fhennecker/semiteleporter/report/final/tasse-defaults-bpa.png

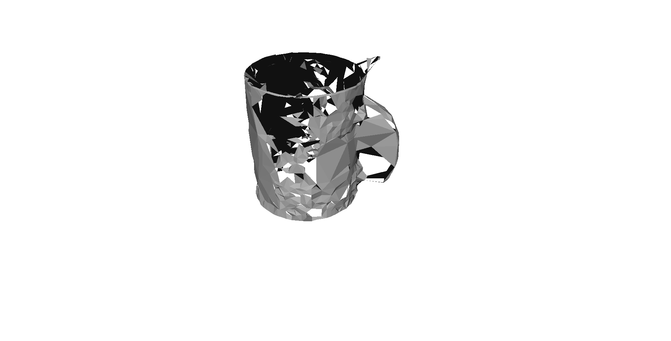
report/final/tasse-defaults-bpa.png
