fhennecker/semiteleporter/research/demo/vase.jpg

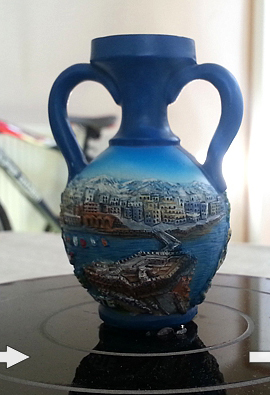
research/demo/vase.jpg
