fhennecker/semiteleporter/research/triangulation_1/11-5+red.bmp

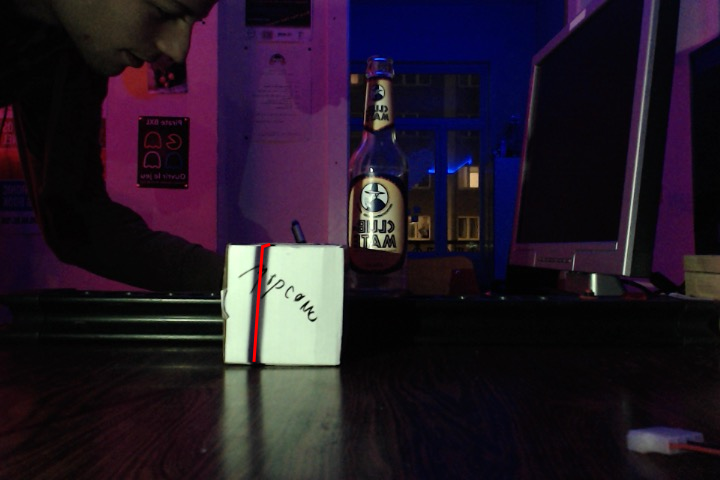
research/triangulation_1/11-5+red.bmp
