fhennecker/semiteleporter/research/triangulation_1/21+red.bmp

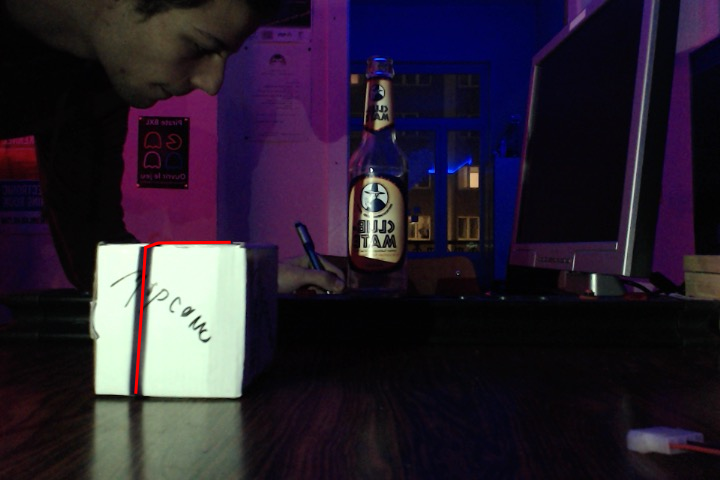
research/triangulation_1/21+red.bmp
