fhennecker/semiteleporter/research/triangulation_1/25+red+cm.bmp

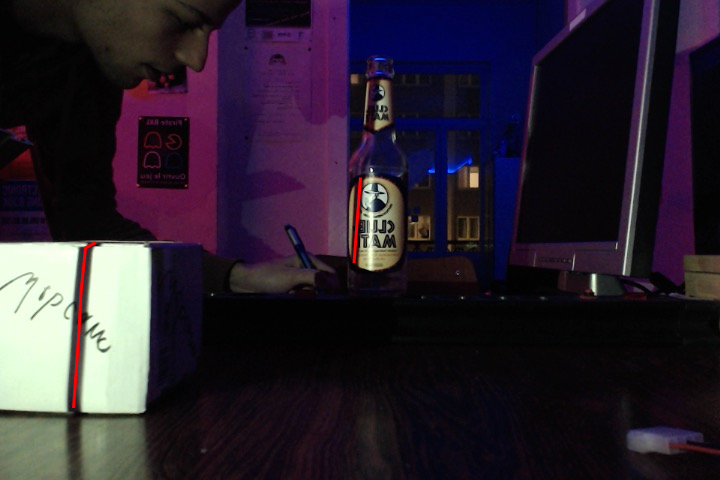
research/triangulation_1/25+red+cm.bmp
