fhennecker/semiteleporter/research/triangulation_1/Photo on 20-11-14 at 20.04 #2.jpg

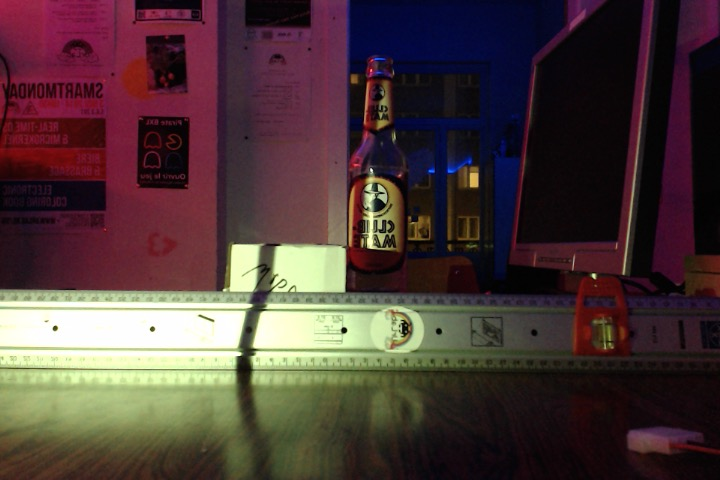
research/triangulation_1/Photo on 20-11-14 at 20.04 #2.jpg
