fhennecker/semiteleporter/research/triangulation_2/repere.png

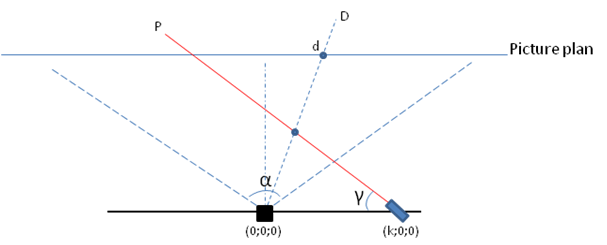
research/triangulation_2/repere.png
