fhennecker/semiteleporter/research/triangulation_3/imgs/04.png

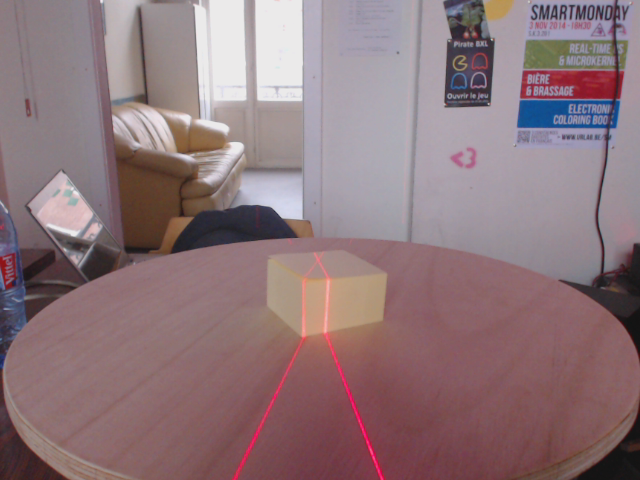
research/triangulation_3/imgs/04.png
