fhennecker/semiteleporter/research/triangulation_3/imgs/14.png

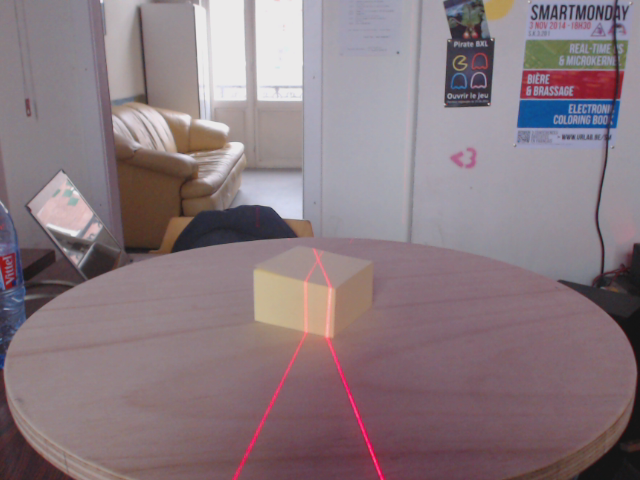
research/triangulation_3/imgs/14.png
