fhennecker/semiteleporter/research/triangulation_3/imgs/32.png

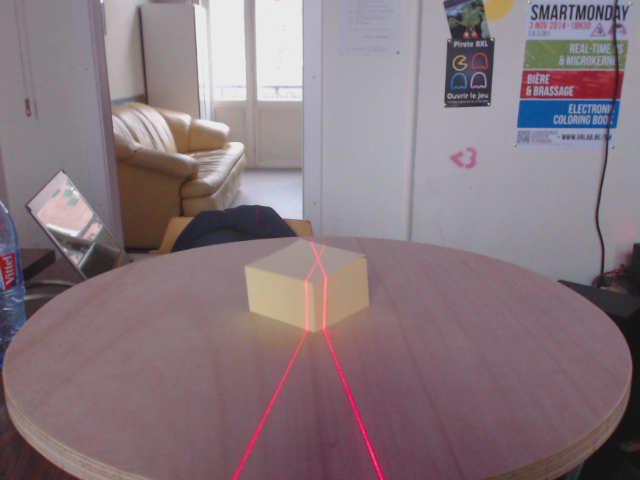
research/triangulation_3/imgs/32.png
