fhennecker/semiteleporter/research/triangulation_3/imgs/45.png

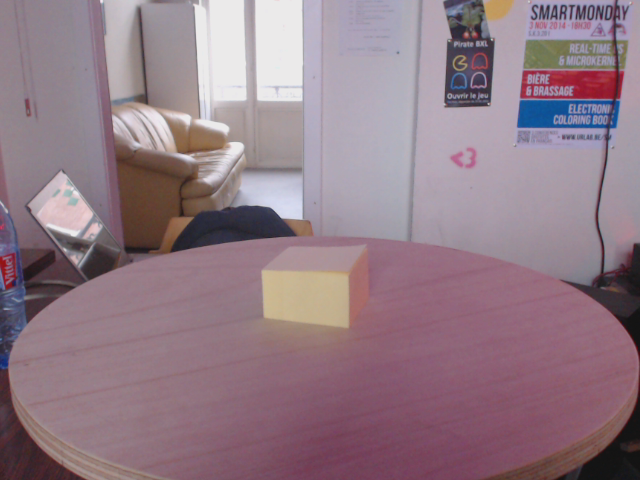
research/triangulation_3/imgs/45.png
