fhennecker/semiteleporter/research/triangulation_3/imgs/50.png

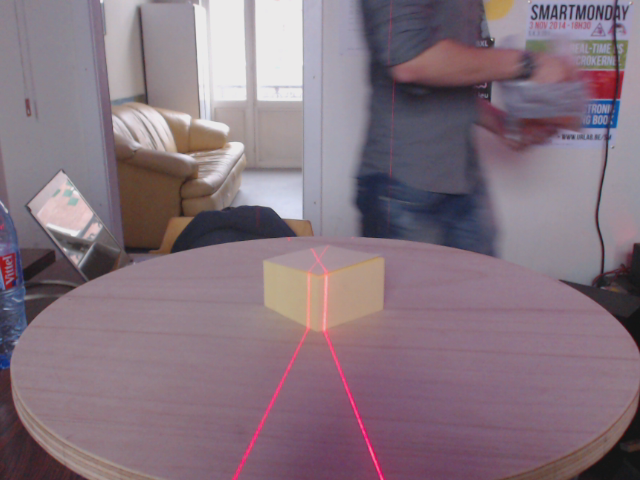
research/triangulation_3/imgs/50.png
