fhennecker/semiteleporter/research/triangulation_3/imgs/51.png

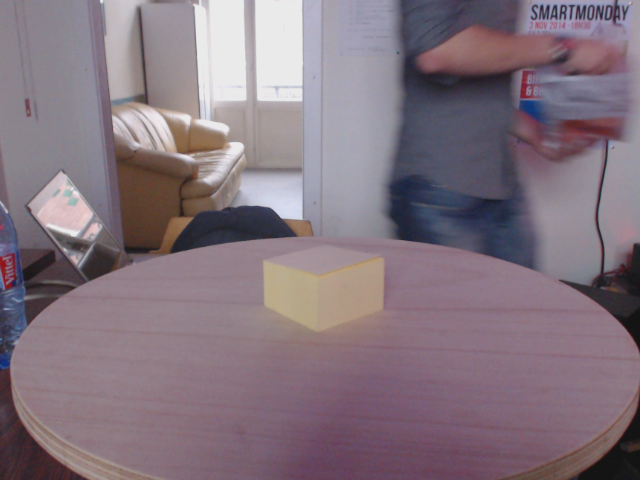
research/triangulation_3/imgs/51.png
