fhennecker/semiteleporter/research/triangulation_4/imgs/00-left.png

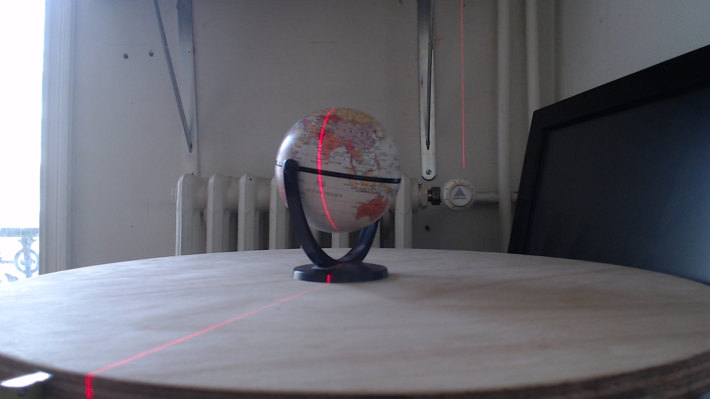
research/triangulation_4/imgs/00-left.png
