fhennecker/semiteleporter/research/triangulation_4/imgs/01-left.png

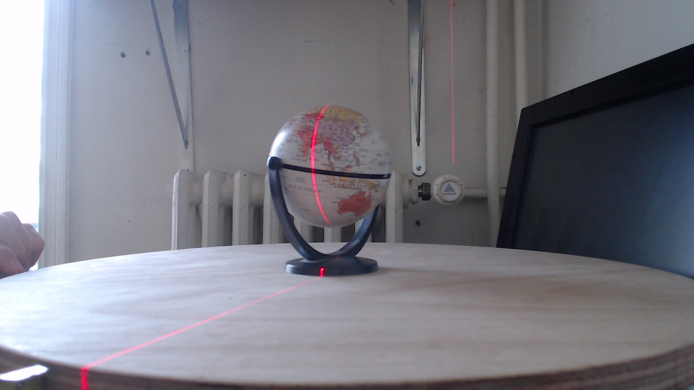
research/triangulation_4/imgs/01-left.png
