fhennecker/semiteleporter/research/triangulation_4/imgs/30-right.png

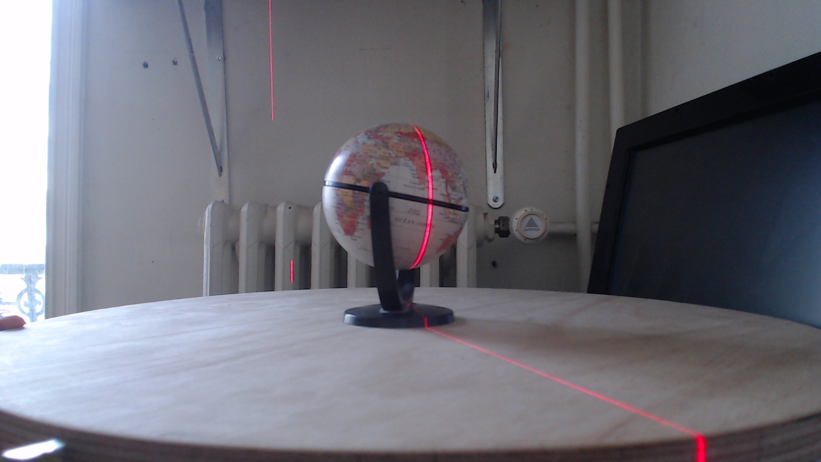
research/triangulation_4/imgs/30-right.png
