fhennecker/semiteleporter/src/points/teapot_up.obj

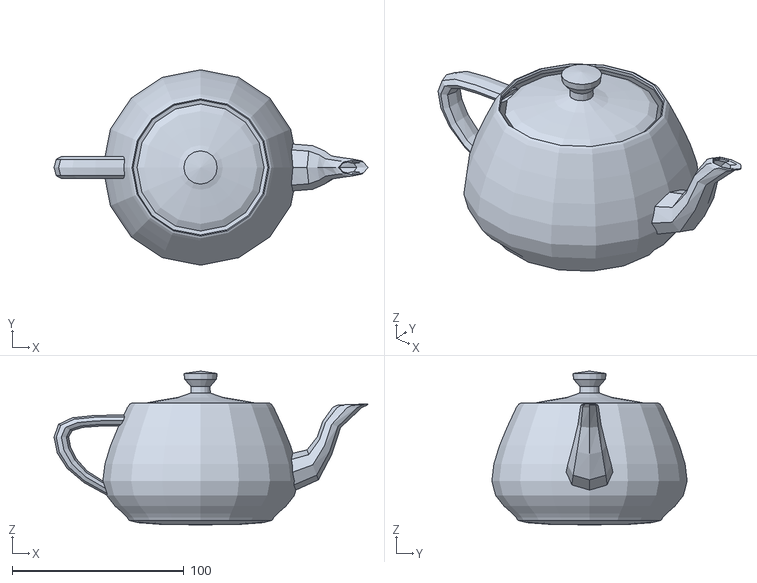
[picture p61: CAD file, 2015-02-26]
src/points/teapot_up.obj
182.7 x 113.7 x 89.5
