fhennecker/semiteleporter/src/points/icoSphere.obj

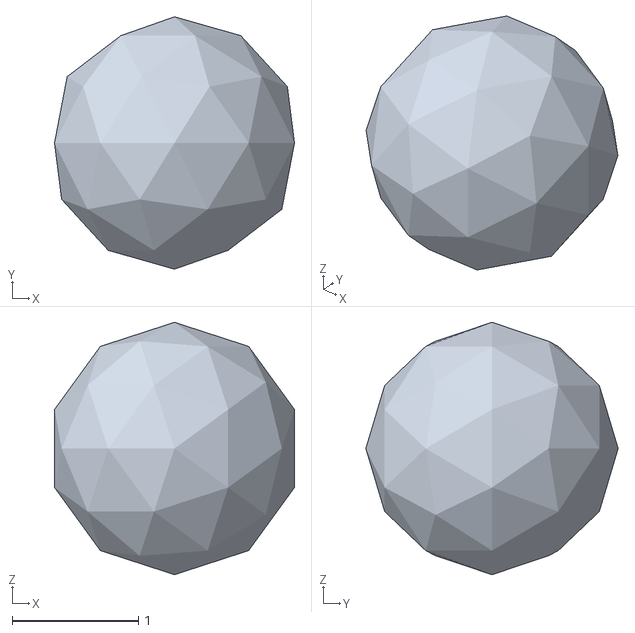
[picture p62: CAD file, 2015-02-26]
src/points/icoSphere.obj
1.90 x 2.00 x 2.00
