fhennecker/semiteleporter/report/final/resultatFinal_jpg.jpg

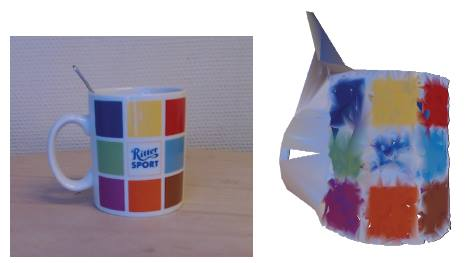
report/final/resultatFinal_jpg.jpg
