fhennecker/semiteleporter/src/default.cfg

[File]
extension = .png
save = ./pictures

[Arduino]
port = /dev/ttyACM0

[LaserRight]
pin = R

[LaserLeft]
pin = L

[Camera]
port = /dev/video1
position = 0.0, 292.0, 0.0
width = 1920.0
height = 1080.0
viewangle = 120.0

[TurnTable]
position = 0.0, 178.0, 350.0
diameter = 500.0
steps = 80.0
