fhennecker/semiteleporter/src/demo/default.cfg

[File]
extension = .png
save = ./pictures

[Arduino]
port = /dev/ttyACM0

[LaserRight]
position = 150.0, 295.0, 0.0
pin = R

[LaserLeft]
position = -150.0, 295.0, 0.0
pin = L

[Camera]
port = /dev/video1
position = 0.0, 295.0, 0.0
rotation = 18.483999, 0.0, 0.0
width = 1920.0
height = 1080.0
viewangle = 120.0

[TurnTable]
position = 0.0, 178.0, 350.0
diameter = 500.0
steps = 32.0
