fhennecker/semiteleporter/(commit log)

2014-11-20 [add] vase picture with fake laser
2014-11-23 Capture program dealing with the arduino.
2014-11-23 code arduino
2014-11-23 Capture dealing with the arduino+code arduino
2014-11-25 change filter filename
2014-12-04 [add] Experiment triangulation with rotation and 2 lasers: images
2014-12-05 [enh] Find laser points with a yield (easier to get them from triangulation)
2014-12-05 [enh] Use same filter.py as in src/
2014-12-05 Arduino driver for EasyDriver
2014-12-05 [enh] Use camera height, and display disk
2014-12-06 filter remodeling
2014-12-08 Adaptation so that each laser can be lit individually.
2014-12-09 [add] Center calibration image
2014-12-10 [add] Camera acquisition script
2014-12-12 add calibration mask
2014-12-13 [fix] pi/2 rotation between left and right lasers
2014-12-14 [add] Calibrate before scan
2014-12-17 [add] Power controlled by Arduino && mo4r calibration images
2014-12-17 [ref] L is now given from plate center to the stand, no more to the camera lens
2014-12-17 [ref] Gui scan buttons
2014-12-17 [add] autofind center when calibrating from gui
2014-12-17 [add] autocenter in calibrate_from_scanner
2014-12-21 [fix] Cannot use GUI without webcam+arduino; also show exceptions
2014-12-21 [fix] Autocalibration integration - Autocalibrate when calibrate from dump - Apply observer pattern
2015-01-27 Comments on gui.py, scanner.py and filter.py
2015-02-02 first step refactoring
    [default.cfg]
2015-02-08 [refactoring] pipeline
    [default.cfg]
2015-02-08 [refactoring] prepared for gui integration
    [default.cfg]
2015-02-12 [refactioring] gui integration
    [default.cfg]
2015-02-12 [refactoring] 'real time' plotting with thread + popup
2015-02-19 [fix] load
    [default.cfg]
2015-02-19 [fix] .obj files were ignored
    [teapot.obj, teapot_pc.obj]
2015-02-21 [add] meshing algorithm up to (not done yet) actual construction of the influence region
    [icoSphere.obj]
2015-02-21 [add] computing points for basic case of influence region
2015-02-21 [enh] Face color and traceback for debugging
2015-02-22 [add] rotated teapot obj
    [teapot_up.obj]
2015-02-23 [add] hsv & rgb filter
2015-02-23 [enh] Shorter logging + close holes
2015-02-24 [enh] Avoid unnecessary filter
2015-02-25 [fix] triangulation, pseudo real-time plot
    [default.cfg]
2015-02-25 [fix] A full rotation is 80 steps
    [default.cfg]
2015-02-26 default config
    [default.cfg]
2015-02-26 [add] Quit button
2015-02-26 [ref] Reorganize modules
    [default.cfg]
2015-02-26 [ref] Integrate meshing into tree
    [icoSphere.obj, teapot.obj, teapot_pc.obj, teapot_up.obj]
2015-02-26 [add] Mesh button (WIP)
2015-02-26 [fix] Vertical is the second component
    [douglaspeucker.py]
2015-02-26 [fix] returning None in case no point is found
2015-02-26 [fix] WE HAZ COLOOOORZ !!!
    [scene.py]
2015-02-27 [enh] Thank you XZibit for pumping my plot
2015-03-15 [add] some method for calibration
    [default.cfg]
2015-03-16 [fix] Remove local config file
    [default.cfg]
2015-03-20 [add] auto-calibration works !
    [default.cfg]
2015-03-22 [add] modify hsv filter to accept high brightness (cyan) from lasers
2015-03-22 [add] image generator & filter demo
    [default.cfg]
2015-03-22 [add] Current git version in exported objs
2015-03-22 [add] use filter_demo with path of images in command line
